rixnobis/rj45-mapper/renders/3d-bottom.png

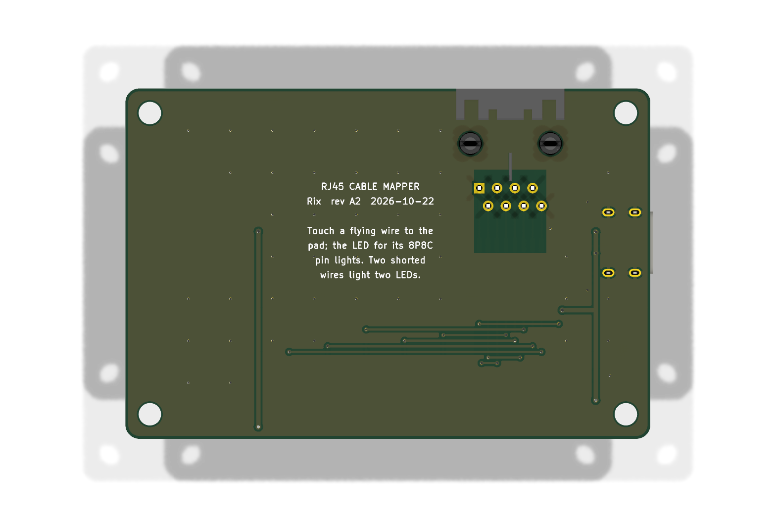
renders/3d-bottom.png
