rixnobis/rj45-mapper/renders/3d-iso.png

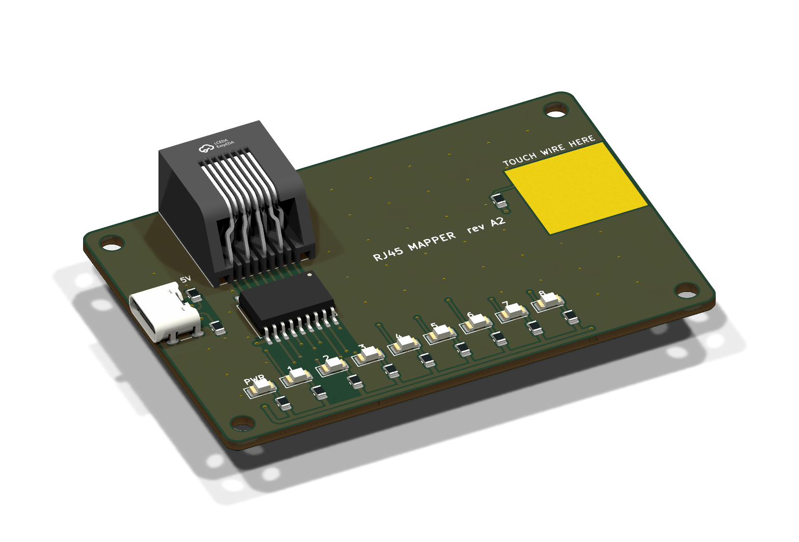
renders/3d-iso.png
