rixnobis/rj45-mapper/renders/3d-top.png

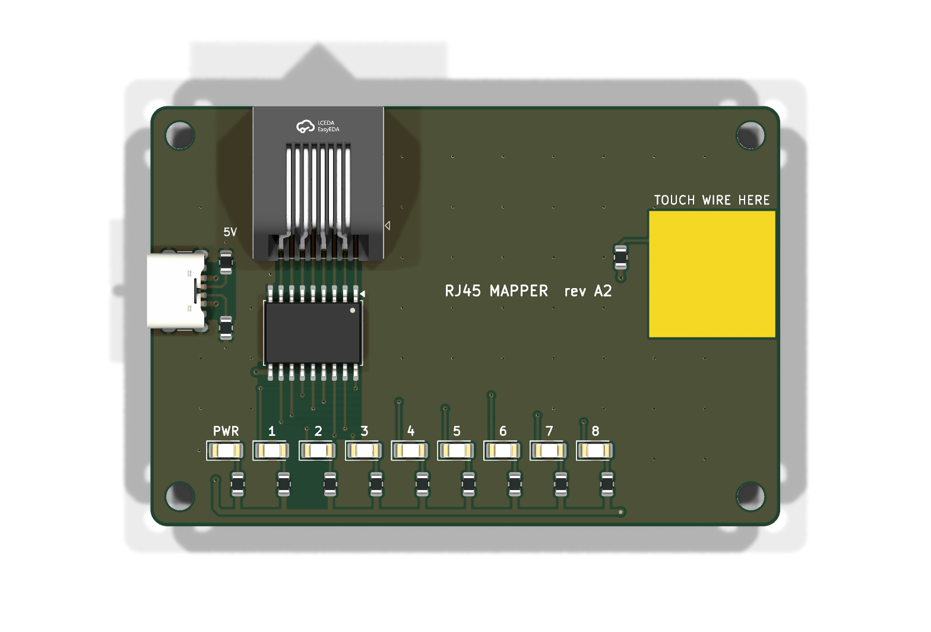
renders/3d-top.png
