rixnobis/rj45-mapper/renders/B.Cu.png

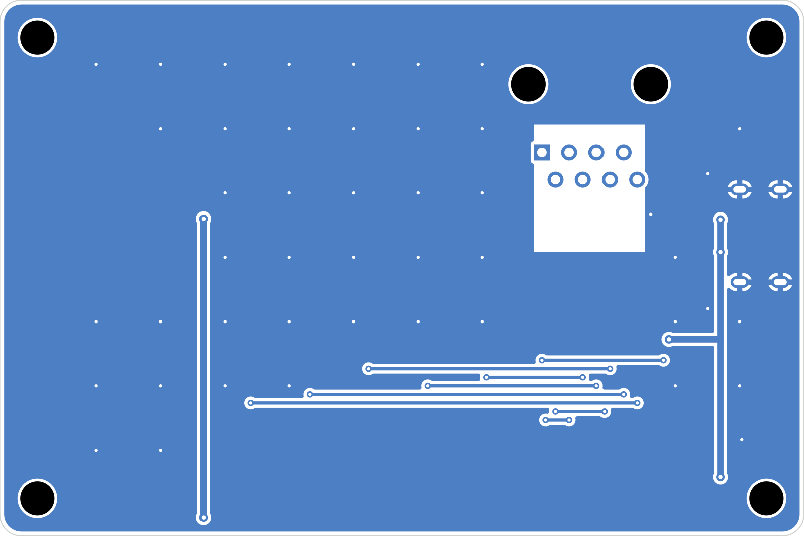
renders/B.Cu.png
