rixnobis/rj45-mapper/renders/B.SilkS.png

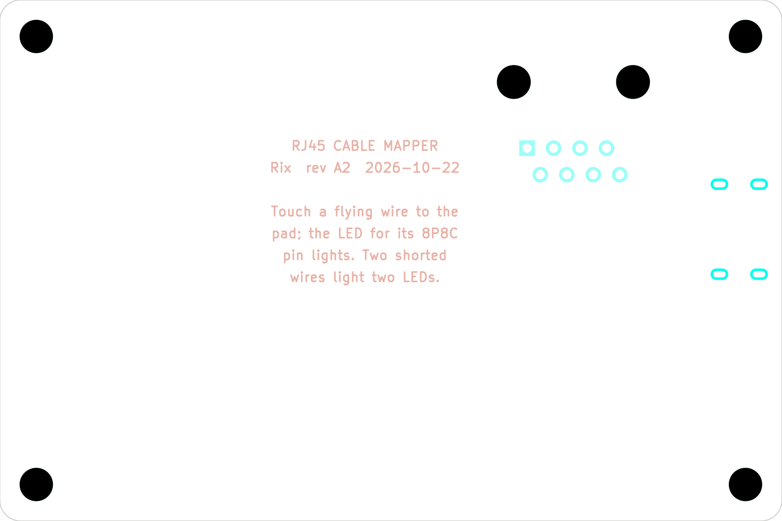
renders/B.SilkS.png
