rixnobis/rj45-mapper/renders/case/base.png

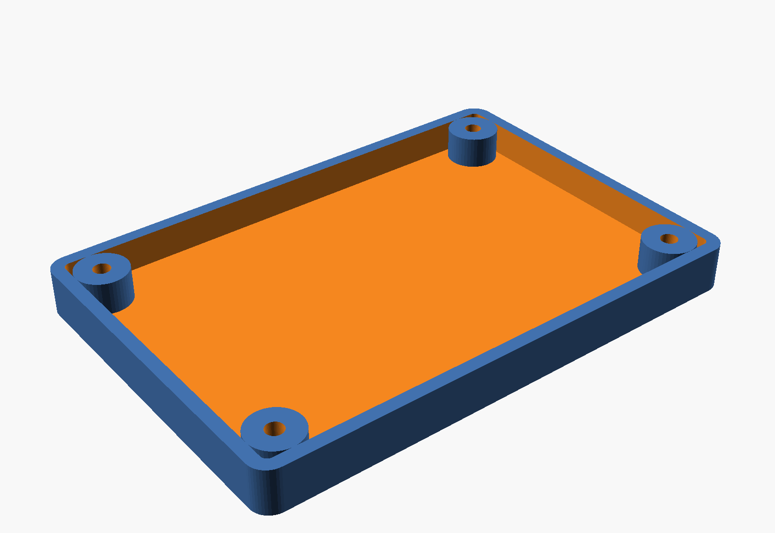
renders/case/base.png
