rixnobis/rj45-mapper/renders/case/jack-side.png

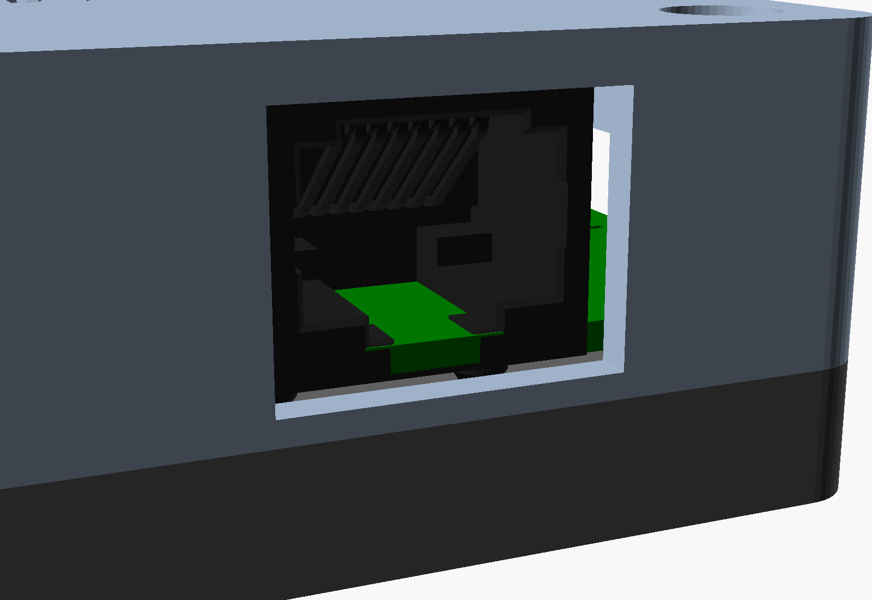
renders/case/jack-side.png
