rixnobis/rj45-mapper/renders/case/lid.png

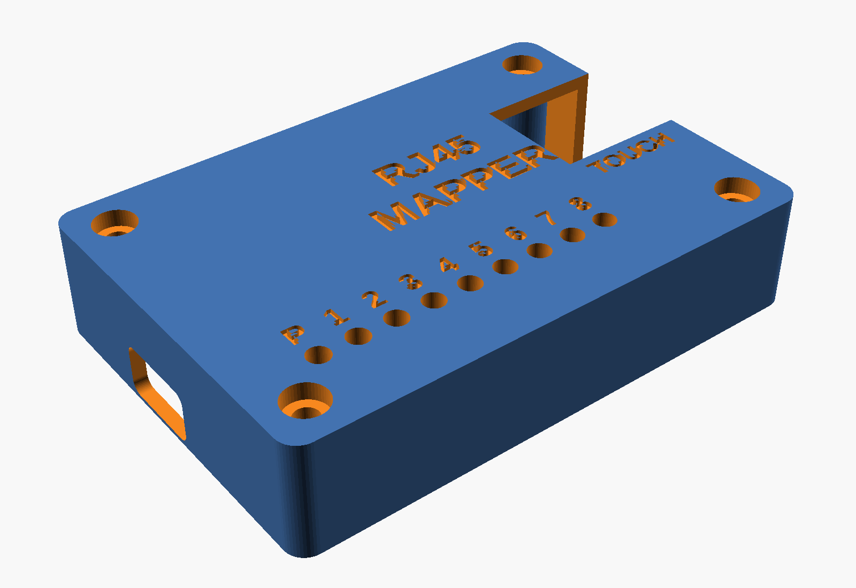
renders/case/lid.png
