rixnobis/rj45-mapper/renders/case/section-jack.png

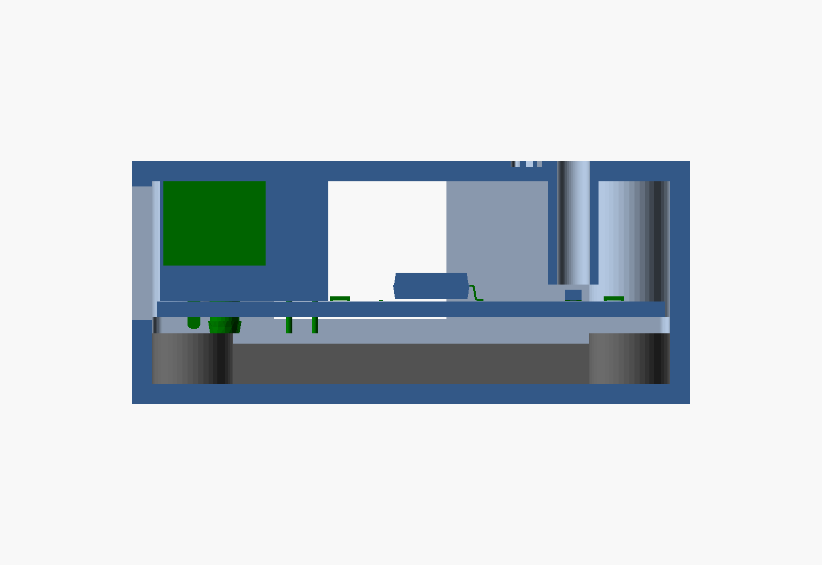
renders/case/section-jack.png
