rixnobis/rj45-mapper/renders/case/section-usb.png

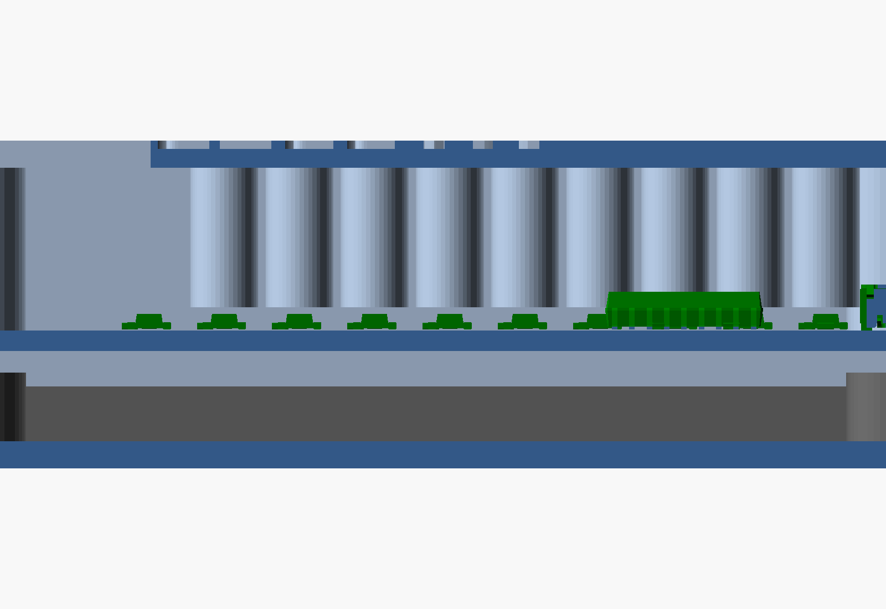
renders/case/section-usb.png
