rixnobis/rj45-mapper/renders/crops/jack-uln.png

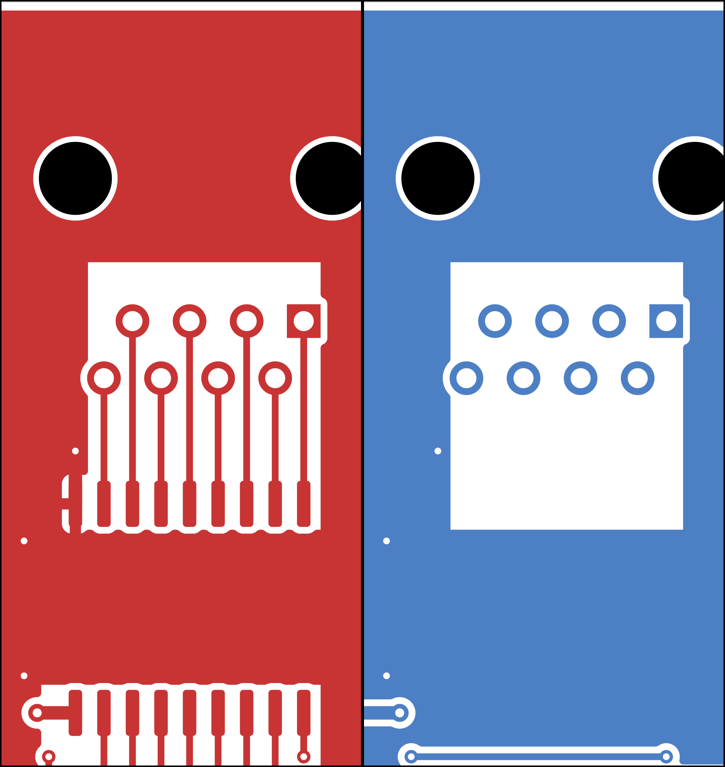
renders/crops/jack-uln.png
