rixnobis/rj45-mapper/renders/crops/leds-r.png

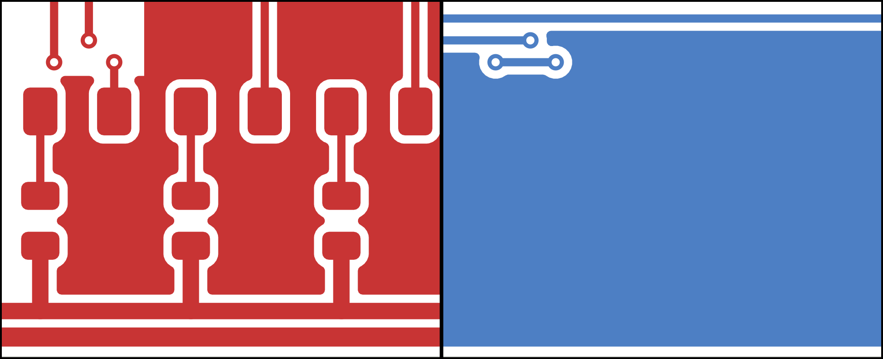
renders/crops/leds-r.png
