rixnobis/rj45-mapper/renders/crops/rows.png

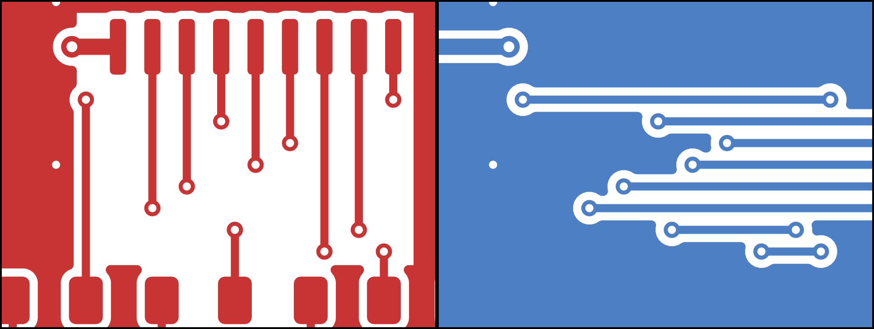
renders/crops/rows.png
