rixnobis/rj45-mapper/renders/crops/shield.png

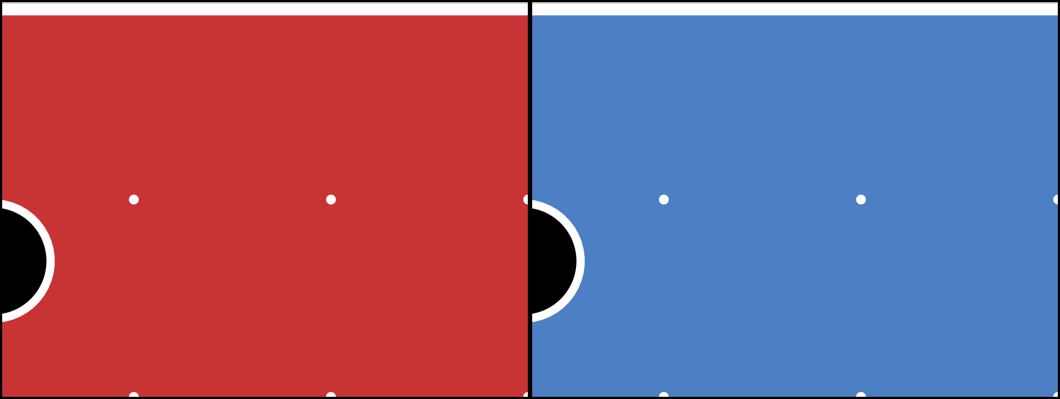
renders/crops/shield.png
