rixnobis/rj45-mapper/renders/crops/usb.png

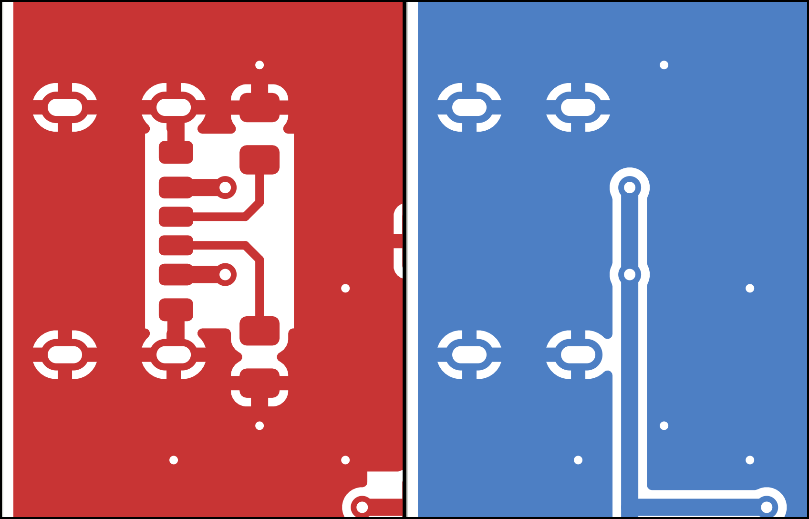
renders/crops/usb.png
