rixnobis/rj45-mapper/renders/F.Cu.png

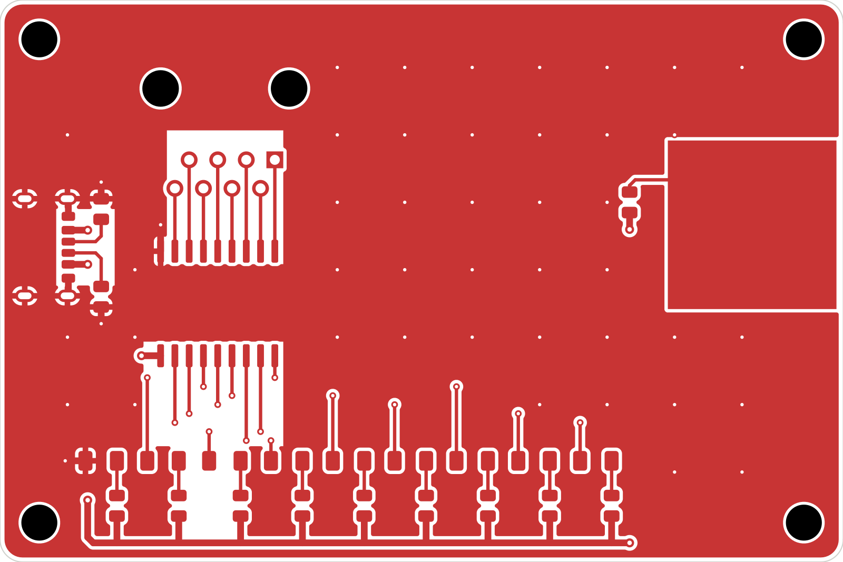
renders/F.Cu.png
