rixnobis/rj45-mapper/renders/F.SilkS.png

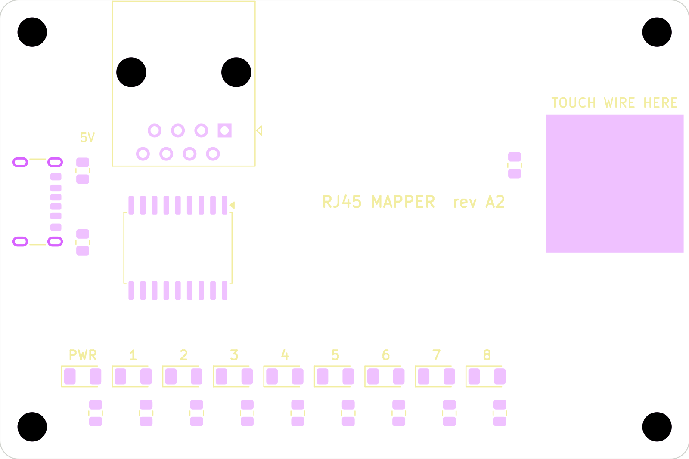
renders/F.SilkS.png
