rixnobis/rj45-mapper/fab/rj45-mapper-bom.csv

Comment | Designator | Footprint | LCSC Part #
RED | D1,D2,D3,D4,D5,D6,D7,D8,D9 | LED_SMD:LED_1206_3216Metric | C84270
USB-C_5V | J2 | Connector_USB:USB_C_Receptacle_GCT_USB4125-xx-x_6P_TopMnt_Horizontal | C3151650
330 | R1,R2,R3,R4,R5,R6,R7,R8 | Resistor_SMD:R_0805_2012Metric | C17630
1k | R9,R10 | Resistor_SMD:R_0805_2012Metric | C17513
5.1k | R11,R12 | Resistor_SMD:R_0805_2012Metric | C27834
ULN2803A | U1 | Package_SO:SOIC-18W_7.5x11.6mm_P1.27mm | C845537
