rixnobis/rj45-mapper/fab/hand-solder.csv

Comment | Designator | Footprint | LCSC Part #
TE 5555164-1 or equal, RA unshielded | J1 | rj45-mapper:RJ45_8P8C_RightAngle
