rixnobis/rj45-mapper/3d/TE_5555164-1.step

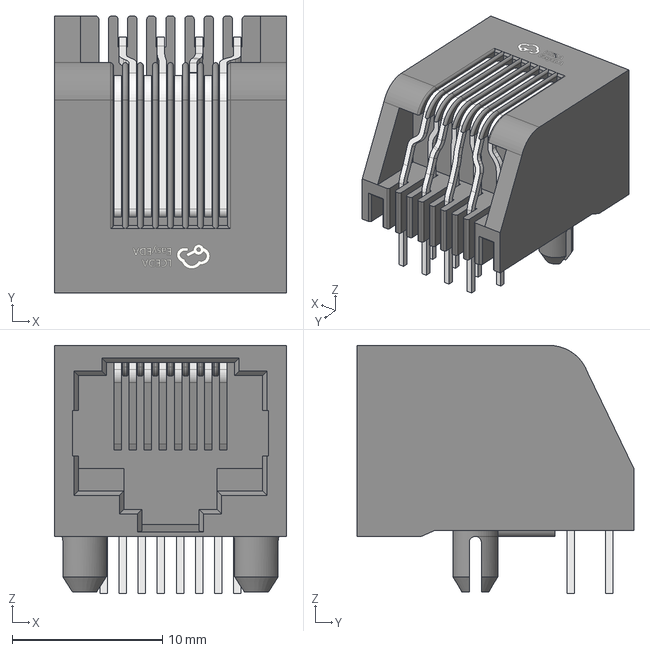
[picture p19: CAD file, 2026-10-22]
3d/TE_5555164-1.step
15.4 x 18.4 x 16.5 mm
