rixnobis/rj45-mapper/case/base.stl

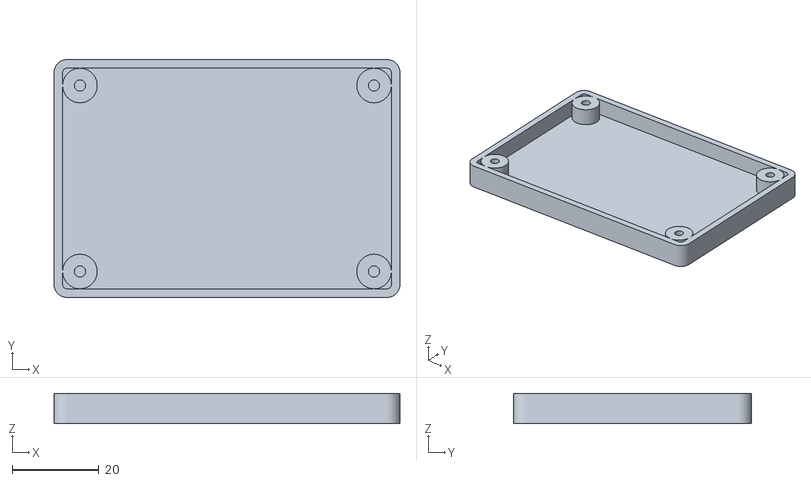
[picture p20: CAD file, 2026-10-23]
case/base.stl
80.0 x 55.0 x 7.00
