rixnobis/rj45-mapper/fab/rj45-mapper.step

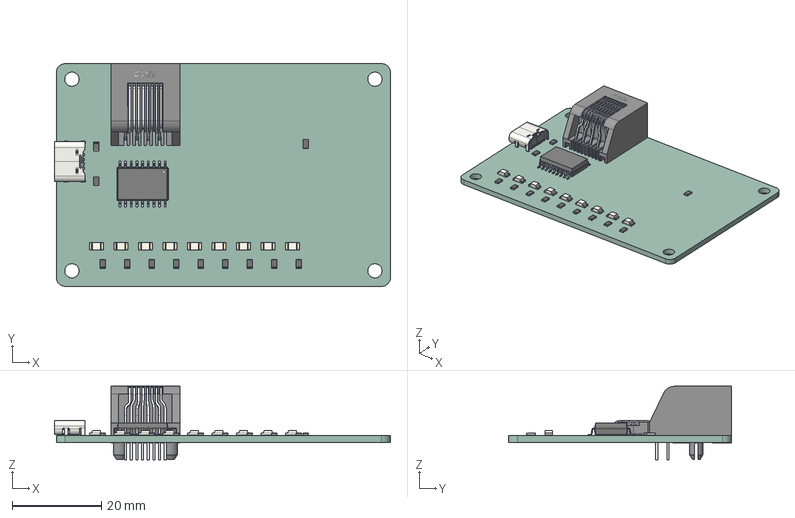
[picture p21: CAD file, 2026-10-22]
fab/rj45-mapper.step
75.4 x 50.0 x 16.5 mm
USB_C_Receptacle_GCT_USB4125-xx-x_6P_TopMnt_Horizontal
R_0805_2012Metric x 12
SOIC-18W_7.5x11.6mm_P1.27mm
LED_1206_3216Metric x 9
rj45-mapper_PCB
