rixnobis/rj45-mapper/case/lid.stl

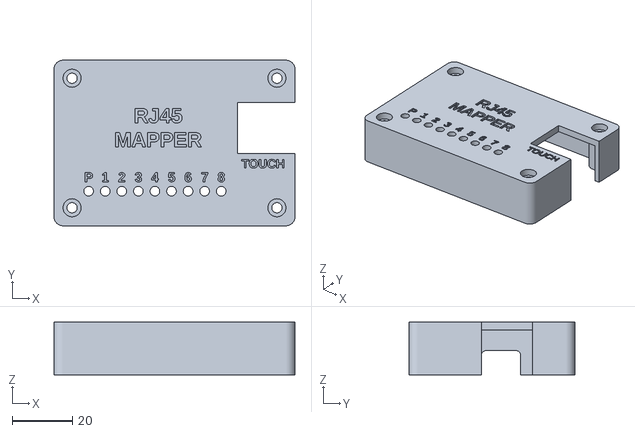
[picture p22: CAD file, 2026-10-23]
case/lid.stl
80.0 x 55.0 x 17.6
