rixnobis/rj45-mapper/schematic.pdf

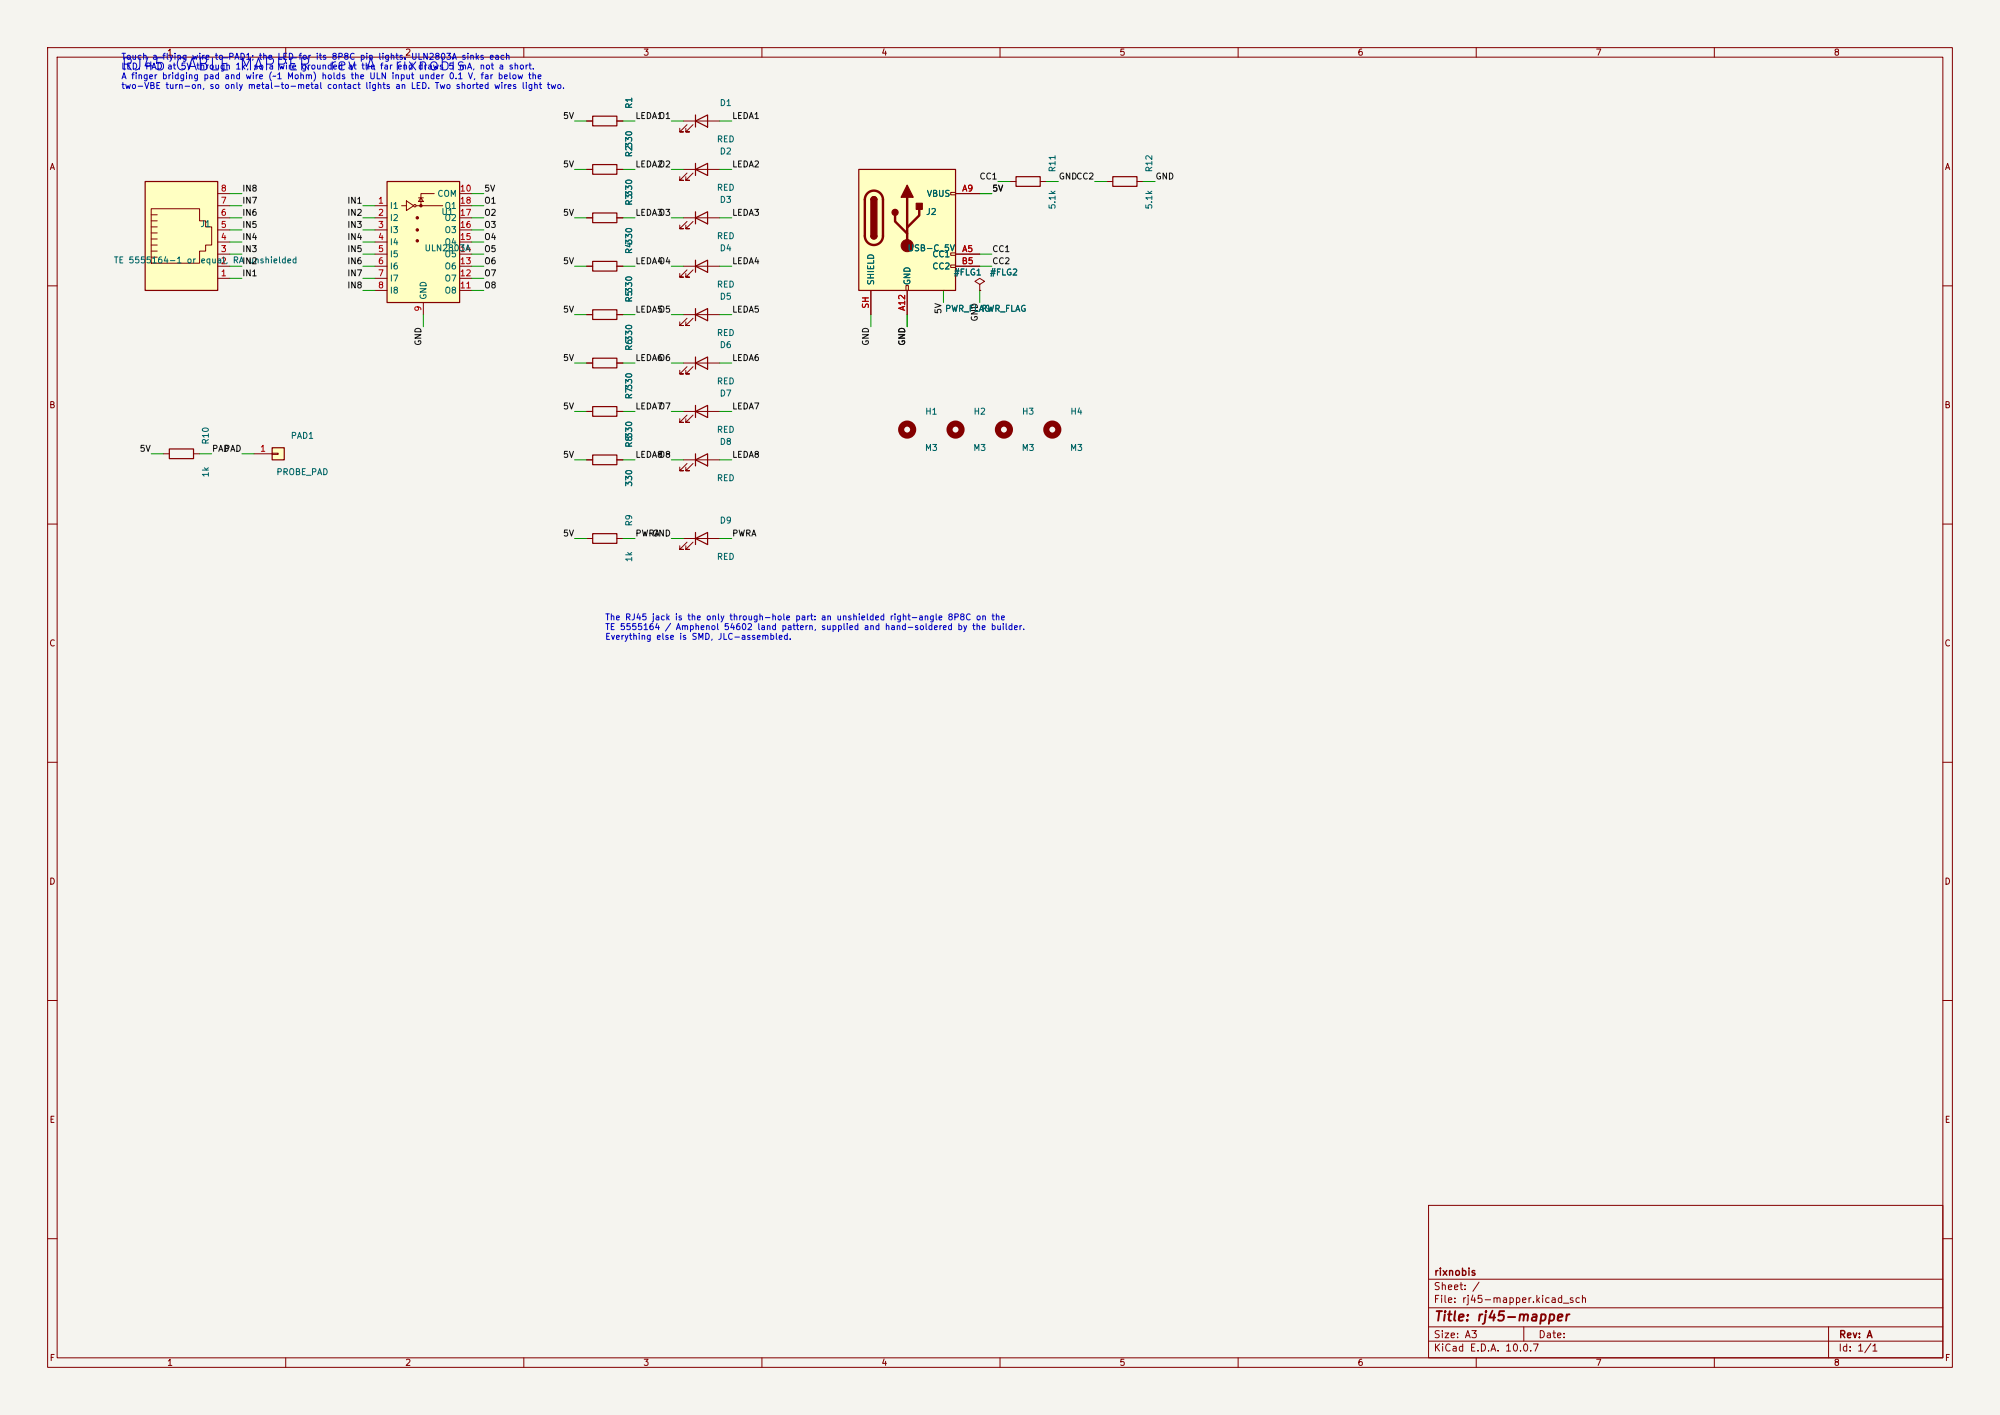
[picture p23: page 1]

Touch a flying wire to PAD1; the LED for its 8P8C pin lights. ULN2803A sinks each
LED. PAD at 5V through 1k, so a wire grounded at the far end draws 5 mA, not a short. A finger bridging pad and wire (~1 Mohm) holds the ULN input under 0.1 V, far below the

The RJ45 jack is the only through-hole part: an unshielded right-angle 8P8C on the
TE 5555164 / Amphenol 54602 land pattern, supplied and hand-soldered by the builder. Everything else is SMD, JLC-assembled.

Size: A3 | Rev: A | F Date:
KiCad E.D.A. 10.0.7 | Id: 1/1
