rixnobis/rj45-mapper/rj45-mapper.kicad_pcb

## KiCad design rj45-mapper.kicad_pcb (2026-10-22)

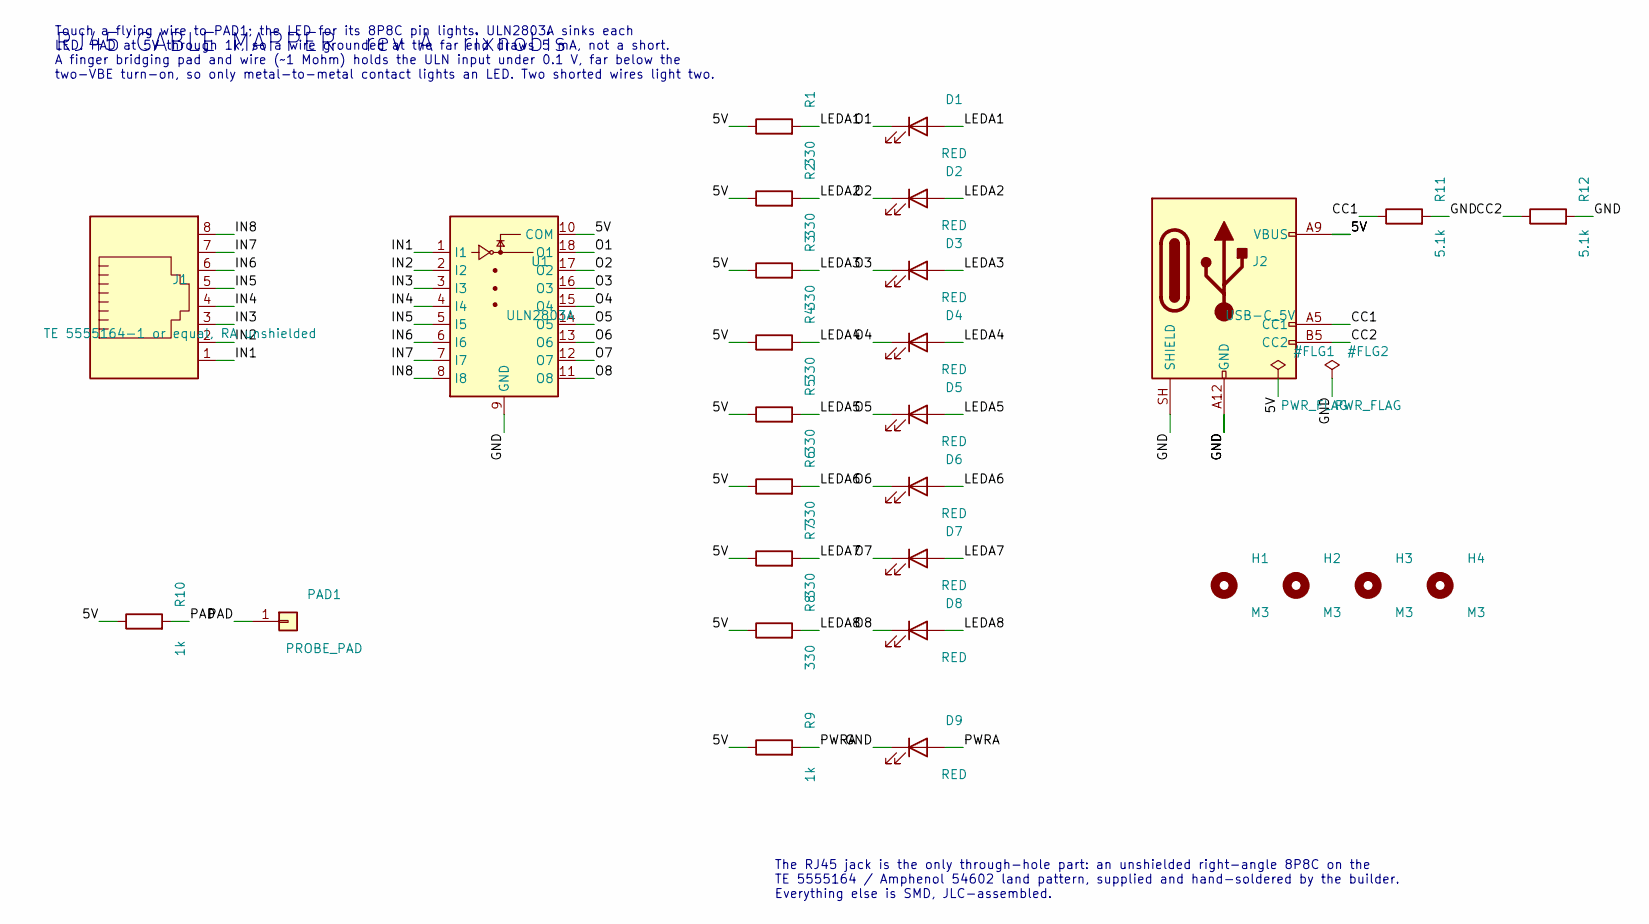
[picture p24: schematic rj45-mapper.kicad_sch]

Parts:
D1, D2, D3, D4, D5, D6, D7, D8, D9: RED; LED_1206_3216Metric; LCSC C84270
H1, H2, H3, H4: M3; MountingHole_3.2mm_M3
J1: TE 5555164-1 or equal, RA unshielded; RJ45_8P8C_RightAngle
J2: USB-C_5V; USB_C_Receptacle_GCT_USB4125-xx-x_6P_TopMnt_Horizontal; LCSC C3151650
PAD1: PROBE_PAD; ProbePad_15x15
R1, R2, R3, R4, R5, R6, R7, R8: 330; R_0805_2012Metric; LCSC C17630
R9, R10: 1k; R_0805_2012Metric; LCSC C17513
R11, R12: 5.1k; R_0805_2012Metric; LCSC C27834
U1: ULN2803A; SOIC-18W_7.5x11.6mm_P1.27mm; LCSC C845537

Connections:
/5V: J2.A9 (VBUS), J2.B9 (VBUS), R1.1, R2.1, R3.1, R4.1, R5.1, R6.1, R7.1, R8.1, R9.1, R10.1, U1.10 (COM)
/CC1: J2.A5 (CC1), R11.1
/CC2: J2.B5 (CC2), R12.1
/GND: D9.1 (K), J2.A12 (GND), J2.B12 (GND), J2.SH (SHIELD), R11.2, R12.2, U1.9 (GND)
/IN1: J1.1, U1.1 (I1)
/IN2: J1.2, U1.2 (I2)
/IN3: J1.3, U1.3 (I3)
/IN4: J1.4, U1.4 (I4)
/IN5: J1.5, U1.5 (I5)
/IN6: J1.6, U1.6 (I6)
/IN7: J1.7, U1.7 (I7)
/IN8: J1.8, U1.8 (I8)
/LEDA1: D1.2 (A), R1.2
/LEDA2: D2.2 (A), R2.2
/LEDA3: D3.2 (A), R3.2
/LEDA4: D4.2 (A), R4.2
/LEDA5: D5.2 (A), R5.2
/LEDA6: D6.2 (A), R6.2
/LEDA7: D7.2 (A), R7.2
/LEDA8: D8.2 (A), R8.2
/O1: D1.1 (K), U1.18 (O1)
/O2: D2.1 (K), U1.17 (O2)
/O3: D3.1 (K), U1.16 (O3)
/O4: D4.1 (K), U1.15 (O4)
/O5: D5.1 (K), U1.14 (O5)
/O6: D6.1 (K), U1.13 (O6)
/O7: D7.1 (K), U1.12 (O7)
/O8: D8.1 (K), U1.11 (O8)
/PAD: PAD1.1, R10.2
/PWRA: D9.2 (A), R9.2

Notes on the sheet:
RJ45 CABLE MAPPER rev A rixnobis
Touch a flying wire to PAD1; the LED for its 8P8C pin lights. ULN2803A sinks each LED. PAD at 5V through 1k, so a wire grounded at the far end draws 5 mA, not a short. A finger bridging pad and wire (~1 Mohm) holds the ULN input under 0.1 V, far below the two-VBE turn-on, so only metal-to-metal con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
The RJ45 jack is the only through-hole part: an unshielded right-angle 8P8C on the TE 5555164 / Amphenol 54602 land pattern, supplied and hand-soldered by the builder. Everything else is SMD, JLC-assembled.

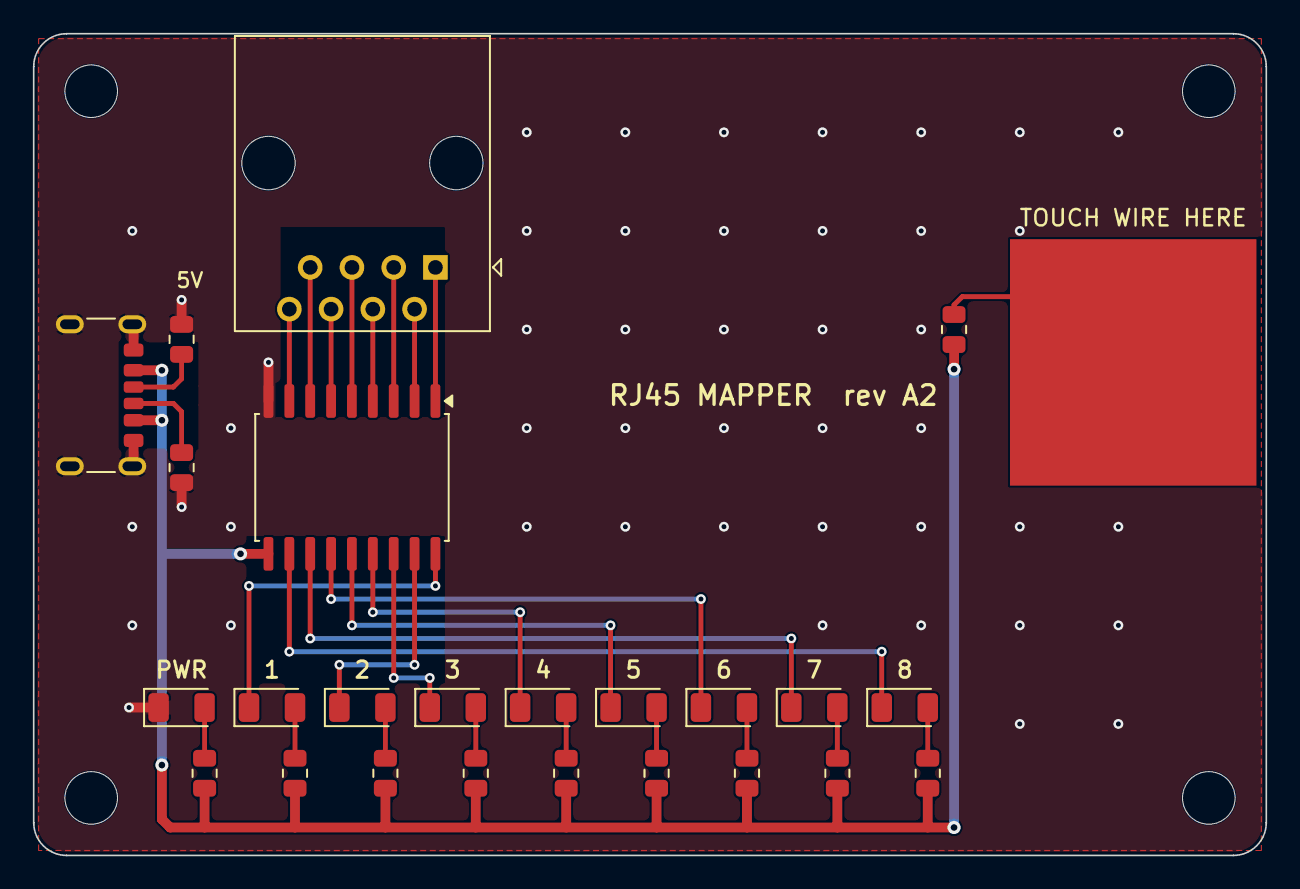
[picture p25: board rj45-mapper.kicad_pcb from above]

Board: 2 copper layers, 75.0 x 50.0 mm, 29 parts (0 on the bottom side), 30 nets.
