rixnobis/rj45-mapper/(commit log)

2026-10-22 RJ45 cable mapper, rev A
    Touch a loose wire of a cable to the pad and the LED for the 8P8C pin it lands
    on lights. ULN2803A sinks eight LEDs, an MMBT3904 drives a ninth from the jack
    shield. JLC assembles everything but the through-hole jack. The scripted route,
    netlist check and geometry check are in tools/build.sh; the OpenSCAD case and its
    fit check are in case/.
    [RJ45-TH_RC01937.step, base.stl, case.scad, hand-solder.csv, lid.stl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]
2026-10-22 Rev A2: right-angle jack on the 8P8C drawing, plug-path check
    The RC01937 is a top-entry jack, so the case wall faced a closed side. J1 is now
    an unshielded right-angle jack on the TE 5555164 / Amphenol 54602 land pattern
    (0.89 mm pins, 3.25 mm pegs), bought separately, with its plug face flush with
    the board edge; the TE model is aligned to the pads and the face. The shield
    channel is gone. fit_check.py now casts rays along the plug path from outside
    the case into the jack.
    [RJ45-TH_RC01937.step, TE_5555164-1.step, base.stl, case.scad, hand-solder.csv, lid.stl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]
2026-10-22 CPL: correct U1 rotation and J2 offset for JLC's own models
    JLC places its EasyEDA models, not the KiCad footprints. Its SOP-18 has pin 1
    bottom-left along the bottom row, so U1 needs -90 on top of KiCad's rotation;
    its USB4125 origin sits 1.15 mm toward the SMD pads. fab.sh applies both.
    [rj45-mapper-B_Cu.gbr, rj45-mapper-B_Mask.gbr, rj45-mapper-B_Silkscreen.gbr, rj45-mapper-Edge_Cuts.gbr, rj45-mapper-F_Cu.gbr, rj45-mapper-F_Mask.gbr, rj45-mapper-F_Paste.gbr, rj45-mapper-F_Silkscreen.gbr]
2026-10-23 case: thicken lid for SLA, move title clear of the probe window
    The SLA wall check flagged the lid: MAPPER ran 0.08 mm into the probe
    window (0.31 mm sliver) and the 0.6 mm deboss left 1.4 mm under the text.
    Lid top is now 2.6 mm (2.0 under text), the title is centred at x 32,
    TOUCH sits 1.9 mm off the window, and the light tubes get a 1.5 mm wall.
    fit_check.py 0.2 passes; it still flags a tube collision with TUBE_GAP
    forced to 0.
    [base.stl, case.scad, lid.stl]
2026-10-23 case: open the lid windows through its bottom edge
    The lid kept a strip under each window (0.57 mm under USB-C, 1.3 mm under
    the jack, 1.4 mm under the probe pad), too thin for SLA. Cut the windows
    down through the lid line; the base wall below is unchanged. fit_check.py
    0.2 still passes.
    [base.stl, case.scad, lid.stl]
